duskmoon314/uno_bthid_60/README.md

# uno_bthid_60

Trying to diy a uno based, bluetooth HID 60 keyboard
