duskmoon314/uno_bthid_60/driver/README.md

# README: uno_bthid_60_driver

The driver is a platformIO project.

## Function

- 矩阵扫描
- 支持两层，默认和 FN
- 功能键单独存储，其余按键存储六个按下
- 使用串口向蓝牙模块发信，进而向计算机输入
