duskmoon314/uno_bthid_60/pcb/README.md

# README: uno_bthid_60_pcb

KiCAD project
