duskmoon314/uno_bthid_60/pcb/uno_bthid_60_pcb/keyboard2.png

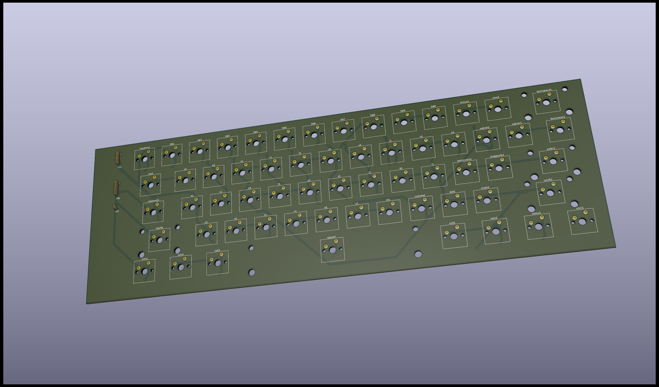
pcb/uno_bthid_60_pcb/keyboard2.png
