duskmoon314/uno_bthid_60/pcb/uno_bthid_60_pcb/keyboard2_auto.kicad_pcb

## KiCad design pcb/uno_bthid_60_pcb/keyboard2_auto.kicad_pcb (2020-08-15)

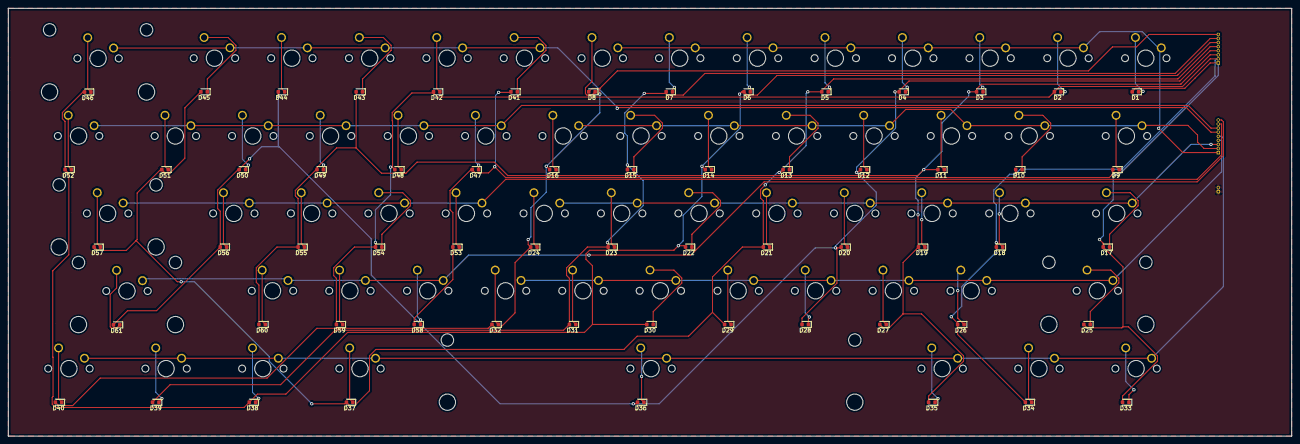
[picture p8: board keyboard2_auto.kicad_pcb from above]

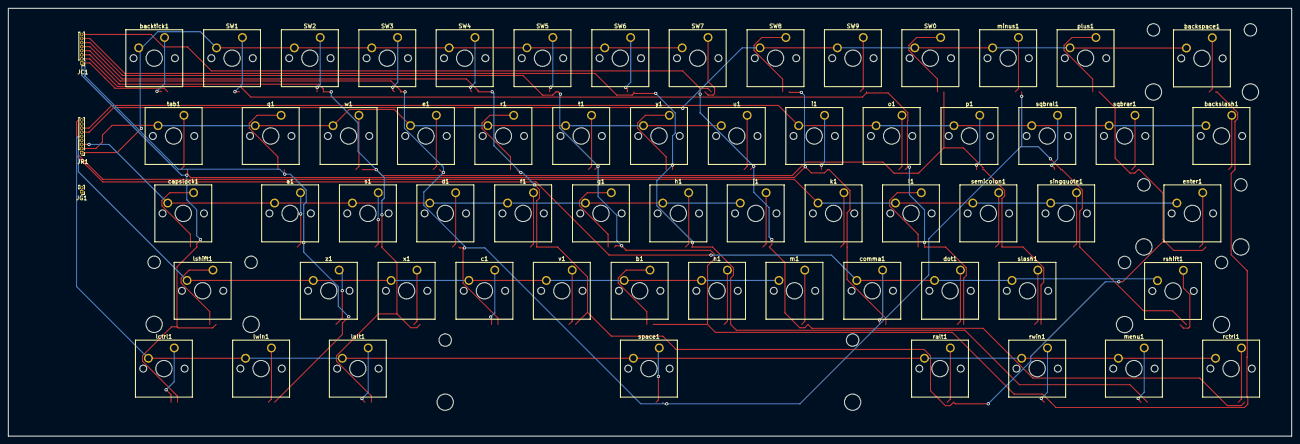
[picture p9: board keyboard2_auto.kicad_pcb from below]

Board: 2 copper layers, 315.0 x 105.0 mm, 125 parts (64 on the bottom side), 79 nets.

Parts:
D1, D2, D3, D4, D5, D6, D7, D8, D9, D10, D11, D12, D13, D14, D15, D16, D17, D18, D19, D20, D21, D22, D23, D24, D25, D26, D27, D28, D29, D30, D31, D32, D33, D34, D35, D36, D37, D38, D39, D40, D41, D42, D43, D44, D45, D46, D47, D48, D49, D50, D51, D52, D53, D54, D55, D56, D57, D58, D59, D60, D61: DIODE; D_0603_1608Metric
JC1: Conn_01x08; PinHeader_1x08_P1.00mm_Vertical
JG1: Conn_01x02; PinHeader_1x02_P1.00mm_Vertical
JR1: Conn_01x09; PinHeader_1x09_P1.00mm_Vertical
SW0, SW1, SW2, SW3, SW4, SW5, SW6, SW7, SW8, SW9: SW_Push; SW_Cherry_MX_1.00u_PCB
a1: SW_Push; SW_Cherry_MX_1.00u_PCB
b1: SW_Push; SW_Cherry_MX_1.00u_PCB
backslash1: SW_Push; SW_Cherry_MX_1.50u_PCB
backspace1: SW_Push; SW_Cherry_MX_2.00u_PCB
backtick1: SW_Push; SW_Cherry_MX_1.00u_PCB
c1: SW_Push; SW_Cherry_MX_1.00u_PCB
capslock1: SW_Push; SW_Cherry_MX_1.75u_PCB
comma1: SW_Push; SW_Cherry_MX_1.00u_PCB
d1: SW_Push; SW_Cherry_MX_1.00u_PCB
dot1: SW_Push; SW_Cherry_MX_1.00u_PCB
e1: SW_Push; SW_Cherry_MX_1.00u_PCB
enter1: SW_Push; SW_Cherry_MX_2.25u_PCB
f1: SW_Push; SW_Cherry_MX_1.00u_PCB
g1: SW_Push; SW_Cherry_MX_1.00u_PCB
h1: SW_Push; SW_Cherry_MX_1.00u_PCB
i1: SW_Push; SW_Cherry_MX_1.00u_PCB
j1: SW_Push; SW_Cherry_MX_1.00u_PCB
k1: SW_Push; SW_Cherry_MX_1.00u_PCB
l1: SW_Push; SW_Cherry_MX_1.00u_PCB
lalt1: SW_Push; SW_Cherry_MX_1.25u_PCB
lctrl1: SW_Push; SW_Cherry_MX_1.25u_PCB
lshift1: SW_Push; SW_Cherry_MX_2.25u_PCB
lwin1: SW_Push; SW_Cherry_MX_1.25u_PCB
m1: SW_Push; SW_Cherry_MX_1.00u_PCB
menu1: SW_Push; SW_Cherry_MX_1.25u_PCB
minus1: SW_Push; SW_Cherry_MX_1.00u_PCB
n1: SW_Push; SW_Cherry_MX_1.00u_PCB
o1: SW_Push; SW_Cherry_MX_1.00u_PCB
p1: SW_Push; SW_Cherry_MX_1.00u_PCB
plus1: SW_Push; SW_Cherry_MX_1.00u_PCB
q1: SW_Push; SW_Cherry_MX_1.00u_PCB
r1: SW_Push; SW_Cherry_MX_1.00u_PCB
ralt1: SW_Push; SW_Cherry_MX_1.25u_PCB
rctrl1: SW_Push; SW_Cherry_MX_1.25u_PCB
rshift1: SW_Push; SW_Cherry_MX_2.75u_PCB
rwin1: SW_Push; SW_Cherry_MX_1.25u_PCB
s1: SW_Push; SW_Cherry_MX_1.00u_PCB
semicolon1: SW_Push; SW_Cherry_MX_1.00u_PCB
singquote1: SW_Push; SW_Cherry_MX_1.00u_PCB
slash1: SW_Push; SW_Cherry_MX_1.00u_PCB
space1: SW_Push; SW_Cherry_MX_6.25u_PCB
sqbral1: SW_Push; SW_Cherry_MX_1.00u_PCB
sqbrar1: SW_Push; SW_Cherry_MX_1.00u_PCB
t1: SW_Push; SW_Cherry_MX_1.00u_PCB
tab1: SW_Push; SW_Cherry_MX_1.50u_PCB
u1: SW_Push; SW_Cherry_MX_1.00u_PCB
v1: SW_Push; SW_Cherry_MX_1.00u_PCB
w1: SW_Push; SW_Cherry_MX_1.00u_PCB
x1: SW_Push; SW_Cherry_MX_1.00u_PCB
y1: SW_Push; SW_Cherry_MX_1.00u_PCB
z1: SW_Push; SW_Cherry_MX_1.00u_PCB

Connections:
/C1: D1.2, D9.2, D17.2, D25.2, D33.2, D41.2, D47.2, D53.2, D58.2, JC1.1
/C2: D2.2, D10.2, D18.2, D26.2, D34.2, D42.2, D48.2, D54.2, D59.2, JC1.2
/C3: D3.2, D11.2, D19.2, D27.2, D35.2, D43.2, D49.2, D55.2, D60.2, JC1.3
/C4: D4.2, D12.2, D20.2, D28.2, D36.2, D44.2, D50.2, D56.2, D61.2, JC1.4
/C5: D5.2, D13.2, D21.2, D29.2, D37.2, D45.2, D51.2, D57.2, JC1.5
/C6: D6.2, D14.2, D22.2, D30.2, D38.2, D46.2, D52.2, JC1.6
/C7: D7.2, D15.2, D23.2, D31.2, D39.2, JC1.7
/C8: D8.2, D16.2, D24.2, D32.2, D40.2, JC1.8
/R1: JR1.1, SW1.2, SW2.2, SW3.2, SW4.2, SW5.2, SW6.2, SW7.2, backtick1.2
/R2: JR1.2, e1.2, q1.2, r1.2, t1.2, tab1.2, u1.2, w1.2, y1.2
/R3: JR1.3, a1.2, capslock1.2, d1.2, f1.2, g1.2, h1.2, j1.2, s1.2
/R4: JR1.4, b1.2, c1.2, lshift1.2, m1.2, n1.2, v1.2, x1.2, z1.2
/R5: JR1.5, lalt1.2, lctrl1.2, lwin1.2, menu1.2, ralt1.2, rctrl1.2, rwin1.2, space1.2
/R6: JR1.6, SW0.2, SW8.2, SW9.2, backspace1.2, minus1.2, plus1.2
/R7: JR1.7, backslash1.2, i1.2, o1.2, p1.2, sqbral1.2, sqbrar1.2
/R8: JR1.8, enter1.2, k1.2, l1.2, semicolon1.2, singquote1.2
/R9: JR1.9, comma1.2, dot1.2, rshift1.2, slash1.2
GND: JG1.1, JG1.2
unnamed: D1.1, backtick1.1
unnamed: D2.1, SW1.1
unnamed: D3.1, SW2.1
unnamed: D4.1, SW3.1
unnamed: D5.1, SW4.1
unnamed: D6.1, SW5.1
unnamed: D7.1, SW6.1
unnamed: D8.1, SW7.1
unnamed: D9.1, tab1.1
unnamed: D10.1, q1.1
unnamed: D11.1, w1.1
unnamed: D12.1, e1.1
unnamed: D13.1, r1.1
unnamed: D14.1, t1.1
unnamed: D15.1, y1.1
unnamed: D16.1, u1.1
unnamed: D17.1, capslock1.1
unnamed: D18.1, a1.1
unnamed: D19.1, s1.1
unnamed: D20.1, d1.1
unnamed: D21.1, f1.1
unnamed: D22.1, g1.1
unnamed: D23.1, h1.1
unnamed: D24.1, j1.1
unnamed: D25.1, lshift1.1
unnamed: D26.1, z1.1
unnamed: D27.1, x1.1
unnamed: D28.1, c1.1
unnamed: D29.1, v1.1
unnamed: D30.1, b1.1
unnamed: D31.1, n1.1
unnamed: D32.1, m1.1
unnamed: D33.1, lctrl1.1
unnamed: D34.1, lwin1.1
unnamed: D35.1, lalt1.1
unnamed: D36.1, space1.1
unnamed: D37.1, ralt1.1
unnamed: D38.1, rwin1.1
unnamed: D39.1, menu1.1
unnamed: D40.1, rctrl1.1
unnamed: D41.1, SW8.1
unnamed: D42.1, SW9.1
unnamed: D43.1, SW0.1
unnamed: D44.1, minus1.1
unnamed: D45.1, plus1.1
unnamed: D46.1, backspace1.1
unnamed: D47.1, i1.1
unnamed: D48.1, o1.1
unnamed: D49.1, p1.1
unnamed: D50.1, sqbral1.1
unnamed: D51.1, sqbrar1.1
unnamed: D52.1, backslash1.1
unnamed: D53.1, k1.1
unnamed: D54.1, l1.1
unnamed: D55.1, semicolon1.1
unnamed: D56.1, singquote1.1
unnamed: D57.1, enter1.1
unnamed: D58.1, comma1.1
unnamed: D59.1, dot1.1
unnamed: D60.1, slash1.1
unnamed: D61.1, rshift1.1
