duskmoon314/uno_bthid_60/(commit log)

2020-08-05 :tada: Initialize pio & kicad project
    [uno_bthid_60_pcb.kicad_pcb, uno_bthid_60_pcb.sch]
2020-08-14 add pcb design
    pcb with iopin pinheaders
    [keyboard2.kicad_pcb, keyboard2.sch]
2020-08-15 Add manual-wiring version
    auto: ugly ugly ugly
    [keyboard2_auto.kicad_pcb, keyboard2_manual.kicad_pcb]
2020-08-15 driver 1.0
2020-08-16 Add PCB doc assets
2020-08-16 Add pcb docs
2021-01-01 [ImgBot] Optimize images
    *Total -- 3,647.84kb -> 3,368.43kb (7.66%)
    /pcb/docs/assets/pcb2_sch.png -- 72.21kb -> 40.43kb (44%)
    /pcb/docs/assets/keyboard_matrix.png -- 230.67kb -> 160.88kb (30.25%)
    /docs/keyboard.png -- 63.89kb -> 45.03kb (29.51%)
    /pcb/docs/assets/pcb2_manual_3d.png -- 1,544.87kb -> 1,457.37kb (5.66%)
    /pcb/uno_bthid_60_pcb/keyboard2.png -- 1,736.21kb -> 1,664.72kb (4.12%)
